marekw1986/WiFiGeiger/hardware/flyback/WiFiGeiger.brd

## EAGLE design hardware/flyback/WiFiGeiger.brd (2020-09-19)

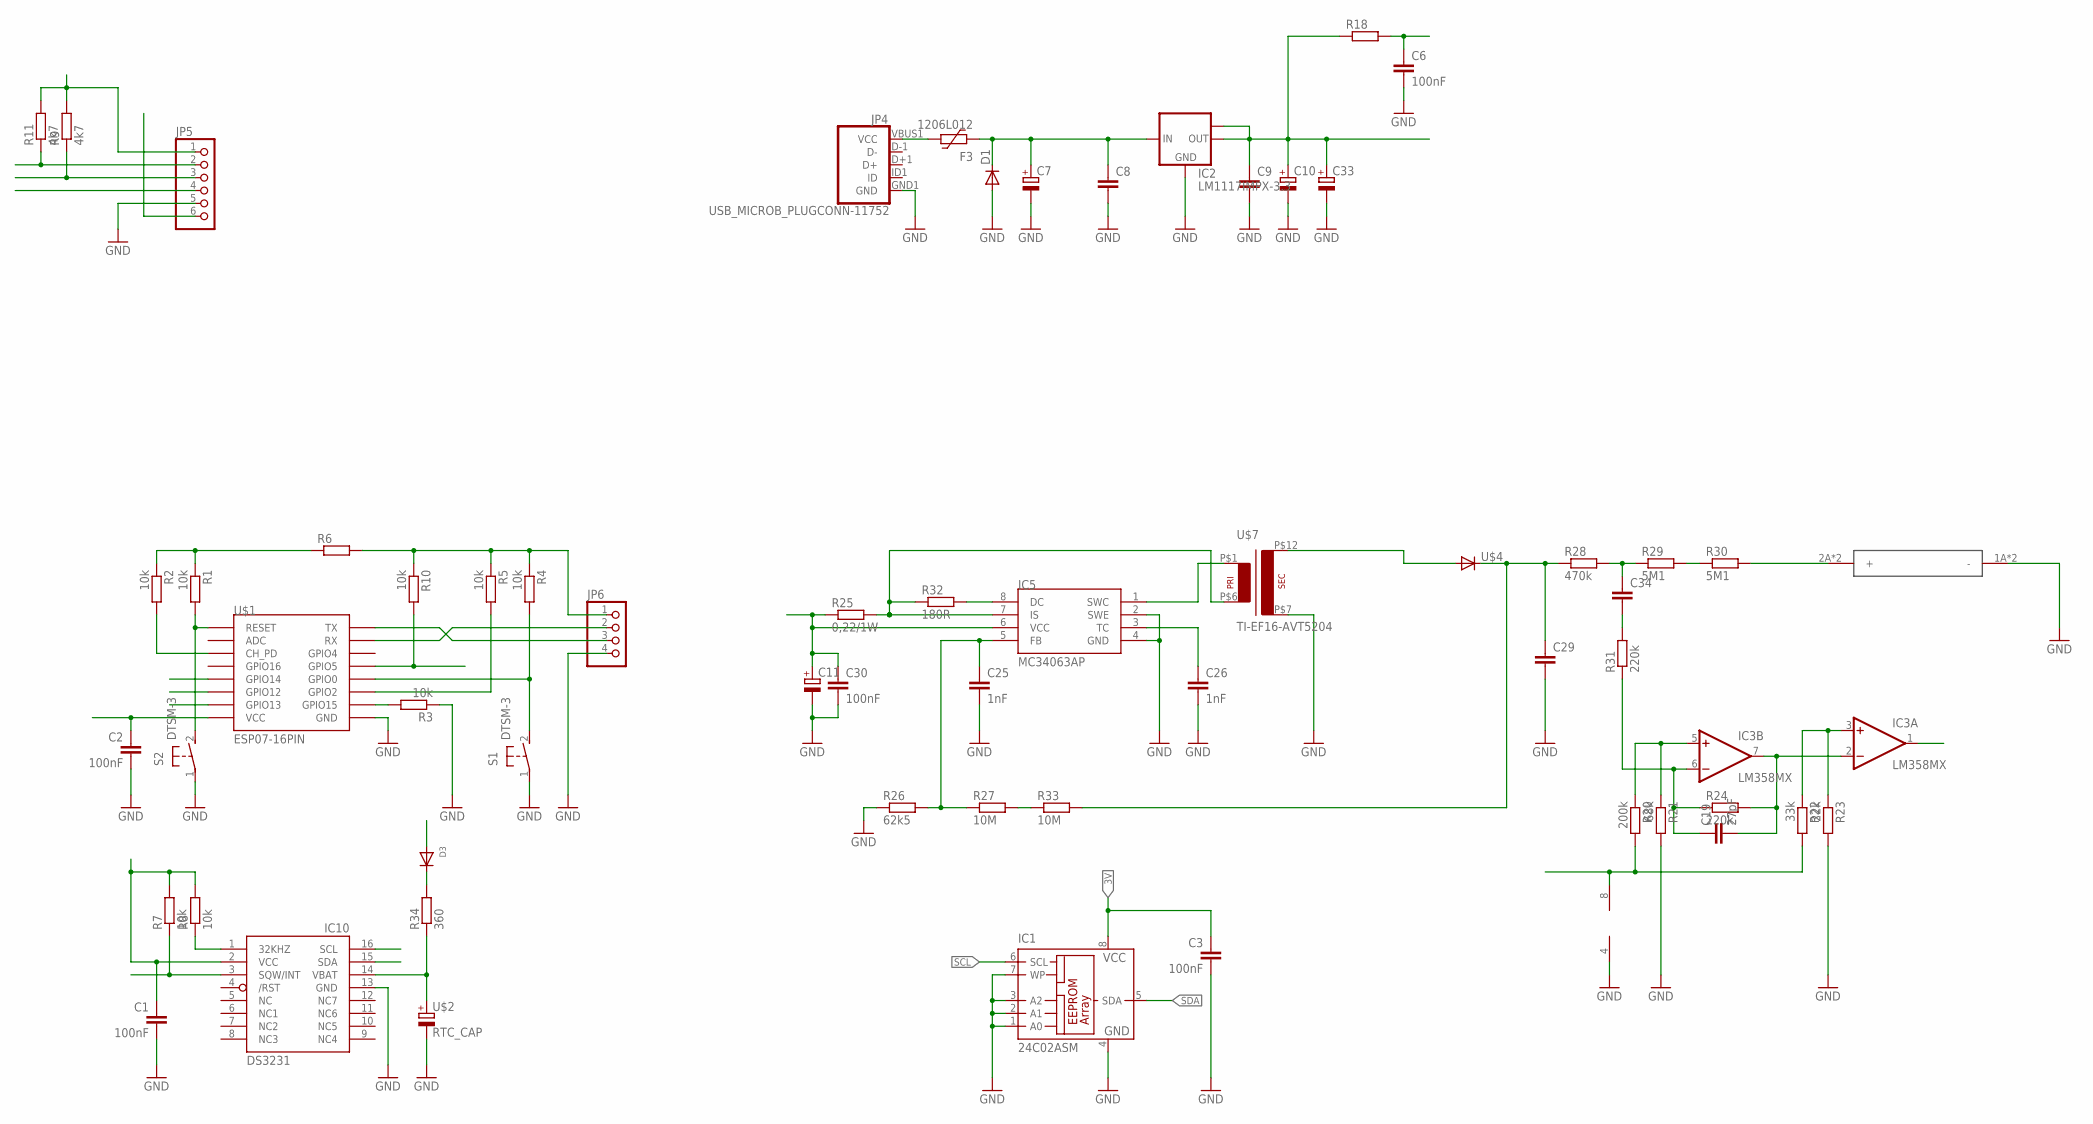
[picture p1: schematic WiFiGeiger.sch]

Parts:
C1, C2, C3, C6, C30: 100nF; C0603
C7, C10: CPOL-EUSMCC; SMC_C
C8, C9: C-EUC1206; C1206
C11: CPOL-EUSMCE; SMC_E
C19: 27pF; C0603
C25, C26: 1nF; C0603
C29: C-EU225-113X268; C225-113X268
C33: CPOL-EUSMCB; SMC_B
C34: C-EU050-024X044; C050-024X044
D1: DIODE-SMB; SMB
D3: DIODESMA; SMADIODE
F3: 1206L012; 1206L
IC1: 24C02ASM; SO-08M
IC2: LM1117IMPX-3.3; SOT223
IC3: LM358MX; SO08
IC5: MC34063AP; DIL08
IC10: DS3231/SO; SO16W
JP4: USB_MICROB_PLUGCONN-11752; USB-B-MICRO-SMD_V03
JP5: PINHD-1X6; 1X06
JP6: PINHD-1X4; 1X04
R1, R2, R3, R4, R5, R7, R8, R10: 10k; R0603
R6: R-EU_R2010; R2010
R9, R11: 4k7; R0603
R18: R-EU_R1206; R1206
R20: 200k; R0603
R21: 68k; R0603
R22: 33k; R1206
R23: 22k; R0603
R24: 220k; R0603
R25: 0,22/1W; R2010
R26: 62k5; R1206
R27, R33: 10M; R2512
R28: 470k; R2512
R29, R30: 5M1; R2512
R31: 220k; R0805
R32: 180R; R0805
R34: 360; R0603
S1, S2: DTSM-3
U$1: ESP07-16PIN
U$2: RTC_CAP
U$4: DIODE-MELF-MLL41; MELF-MLL41
U$5: STS5; GEIGERTUBE
U$7: TI-EF16-AVT5204; EF16-K-H-12P-12,5

Connections:
3V: JP6.1, R4.1, R5.1, R6.2, R10.1
A_3V: C6.1, IC3.8 (V+), R18.2, R20.2, R22.2
CPM: IC3.1 (OUT), R10.2, U$1.GPIO5
GND: C1.2, C2.2, C3.2, C6.2, C7.-, C8.2, C9.2, C10.-, C11.-, C25.2, C26.2, C29.2, C30.2, C33.-, D1.A, IC1.1 (A0), IC1.2 (A1), IC1.3 (A2), IC1.4 (GND), IC1.7 (WP), IC2.1 (GND), IC3.4 (V-), IC5.2 (SWE), IC5.4 (GND), IC10.13 (GND), JP4.GND1 (GND), JP5.5, JP6.4, R3.1, R21.2, R23.2, R26.1, S1.1, S2.1, U$1.GND, U$2.P$2 (-), U$5.1A (-), U$5.1B (-), U$7.P$7 (P7)
HV: C29.1, R28.1, R33.2, U$4.C
IO_INT: JP5.4
unnamed: R1.2, S2.2, U$1.REST (RESET)
unnamed: R2.2, U$1.CH_PD
unnamed: IC5.7 (IS), R25.2, R32.1, U$7.P$6 (P6)
unnamed: C19.1, IC3.6 (-IN), R24.1, R31.1
unnamed: R3.2, U$1.GPIO15
unnamed: R4.2, S1.2, U$1.GPIO0
unnamed: C19.2, IC3.2 (-IN), IC3.7 (OUT), R24.2
unnamed: R5.2, U$1.GPIO2
unnamed: C26.1, IC5.3 (TC)
unnamed: IC10.14 (VBAT), R34.1, U$2.P$1 (+)
unnamed: IC10.1 (32KHZ), R8.1
unnamed: F3.1, JP4.VBUS1 (VCC)
unnamed: JP6.3, U$1.TX
unnamed: D3.C, R34.2
unnamed: IC3.5 (+IN), R20.1, R21.1
unnamed: IC3.3 (+IN), R22.1, R23.1
unnamed: U$4.A, U$7.P$12 (P12)
unnamed: JP6.2, U$1.RX
unnamed: C25.1, IC5.5 (FB), R26.2, R27.1
unnamed: R30.2, U$5.2A (+), U$5.2B (+)
unnamed: R29.2, R30.1
unnamed: C34.1, R28.2, R29.1
unnamed: C34.2, R31.2
unnamed: IC5.1 (SWC), U$7.P$1 (P1)
unnamed: IC5.8 (DC), R32.2
unnamed: R27.2, R33.1
SCL: IC1.6 (SCL), IC10.16 (SCL), JP5.3, R9.1, U$1.GPIO12
SDA: IC1.5 (SDA), IC10.15 (SDA), JP5.2, R11.1, U$1.GPIO13
SQW: IC10.3 (SQW/INT), R7.1, U$1.GPIO14
VBUS: C7.+, C8.1, C11.+, C30.1, D1.C, F3.2, IC2.3 (IN), IC5.6 (VCC), JP5.6, R25.1
_3V: C1.1, C2.1, C3.1, C9.1, C10.+, C33.+, D3.A, IC1.8 (VCC), IC2.2 (OUT), IC2.TAB (OUT1), IC10.2 (VCC), JP5.1, R1.1, R2.1, R6.1, R7.2, R8.2, R9.2, R11.2, R18.1, U$1.VCC

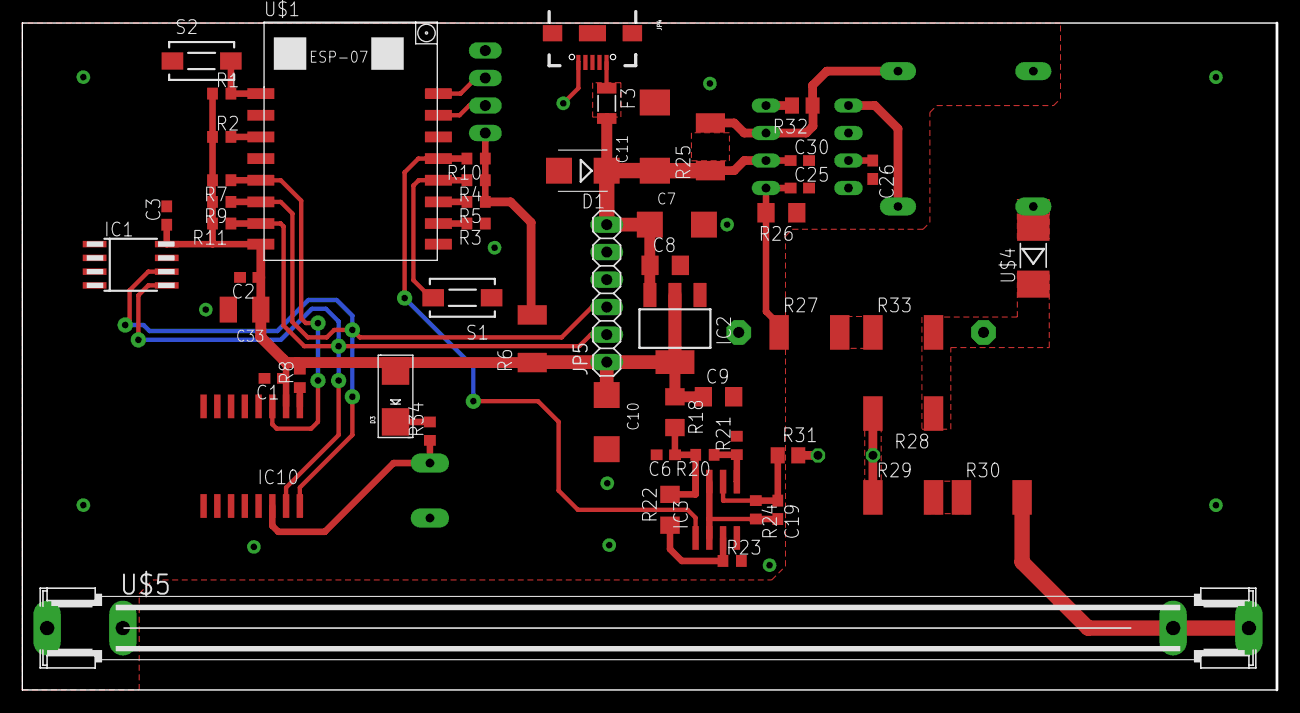
[picture p2: board WiFiGeiger.brd from above]

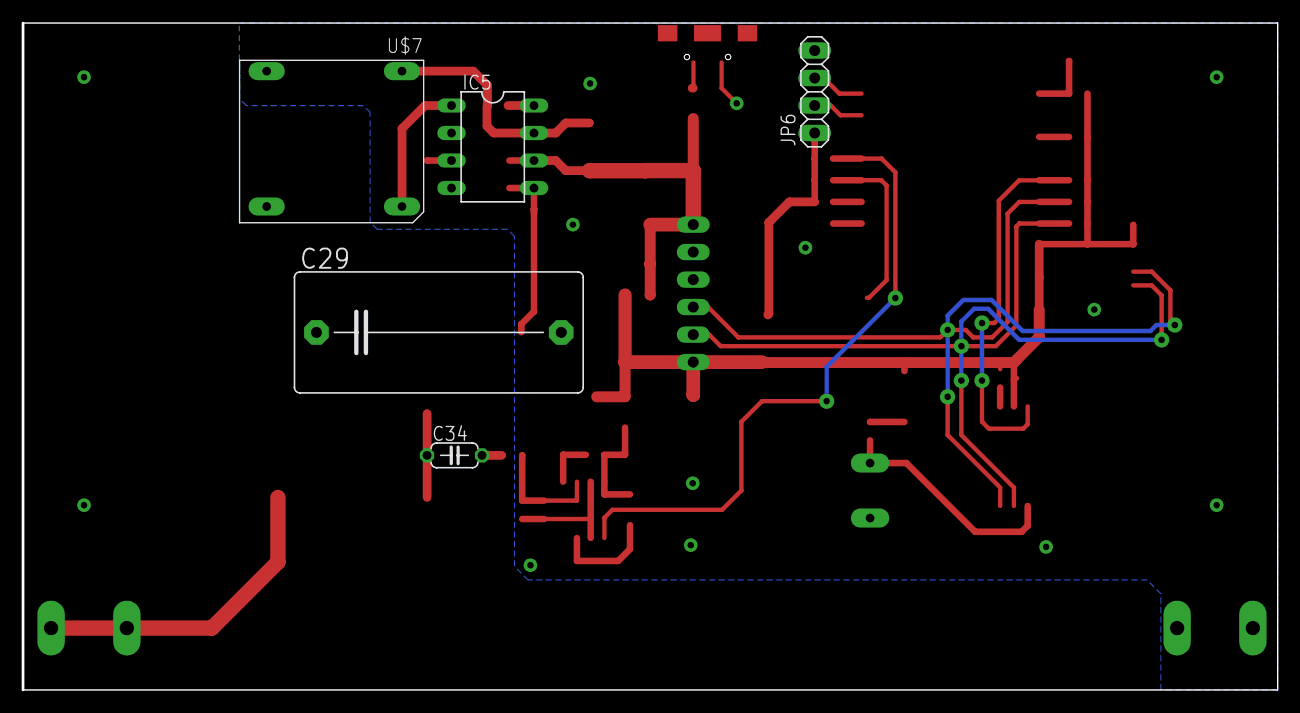
[picture p3: board WiFiGeiger.brd from below]

Board: 2 copper layers, 115.9 x 61.6 mm, 61 parts (5 on the bottom side), 36 nets.
