marekw1986/WiFiGeiger/hardware/io.brd

## EAGLE design hardware/io.brd (2020-09-19)

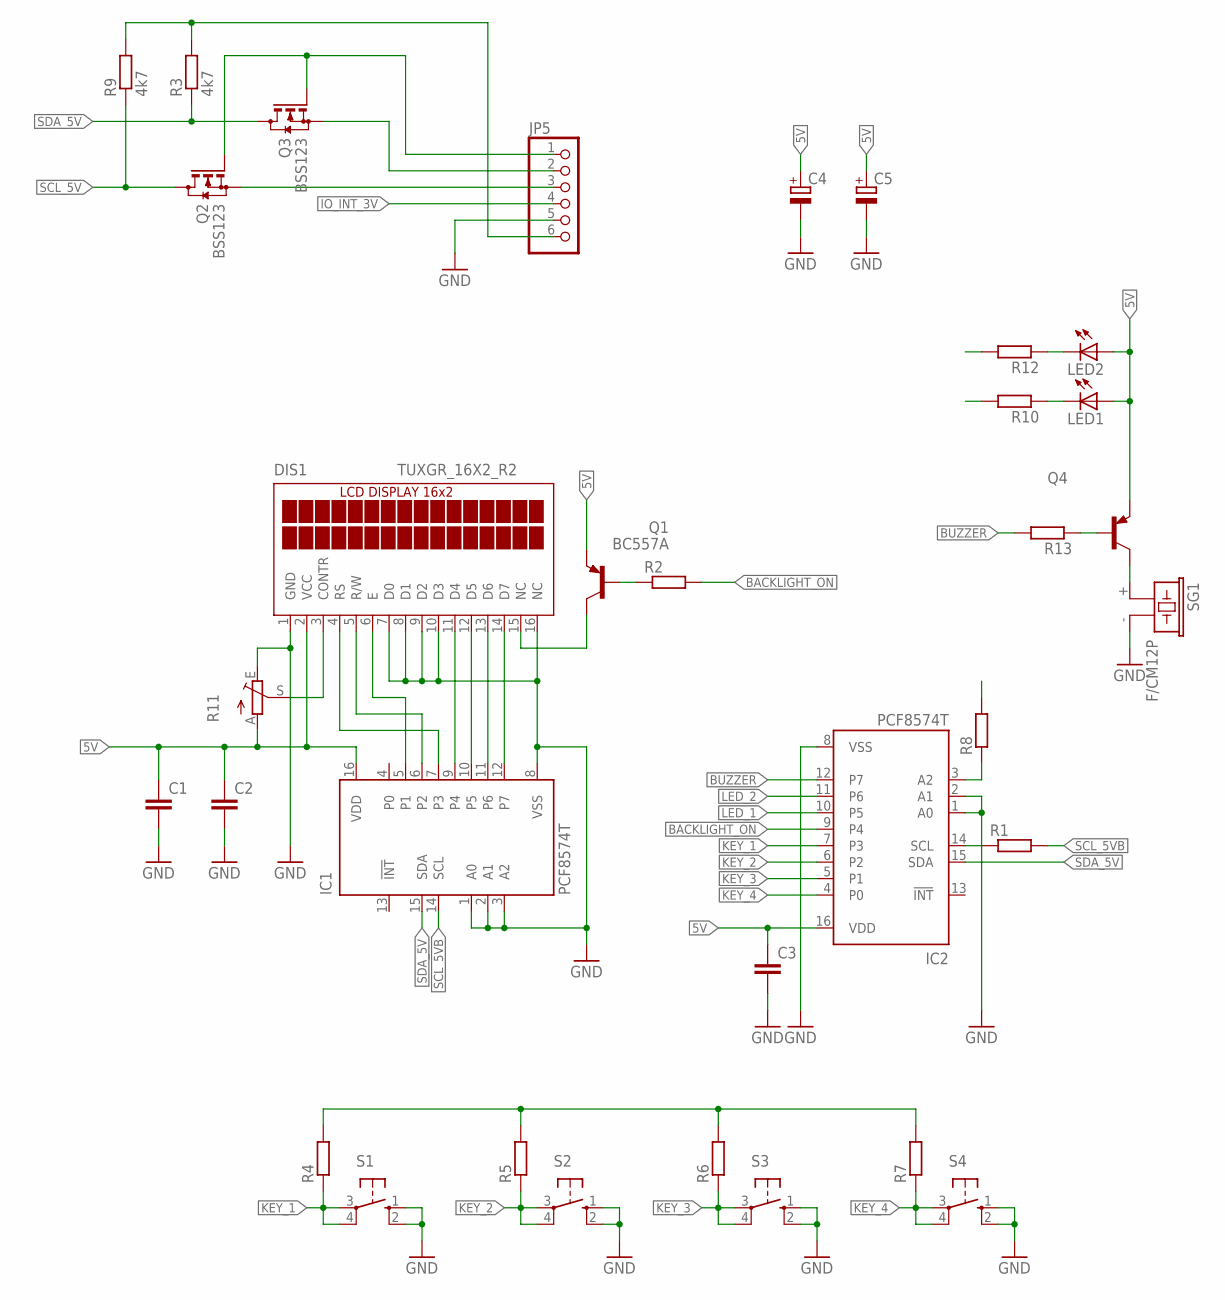
[picture p4: schematic io.sch]

Parts:
C1, C3: C-EUC1206; C1206
C2: C-EUC0603; C0603
C4, C5: CPOL-EUSMCD; SMC_D
DIS1: TUXGR_16X2_R2
IC1, IC2: PCF8574T; SO16W
JP5: PINHD-1X6; 1X06
LED1, LED2: LED5MM
Q1: BC557A; TO92-EBC
Q2, Q3: BSS123; SOT23
Q4: BC557A-PNP-TO92-EBC; TO92-EBC
R1, R8, R13: R-EU_R0603; R0603
R2, R6, R7, R10, R12: R-EU_0204/5; 0204/5
R3: 4k7; R0603
R4, R5: R-EU_0204/7; 0204/7
R9: 4k7; R1206
R11: TRIM_EU-B25U; B25U
S1, S2, S3, S4: 10-XX; B3F-10XX
SG1: F/CM12P

Connections:
5V: C1.1, C2.1, C3.1, C4.+, C5.+, DIS1.2 (VCC), IC1.16 (VDD), IC2.16 (VDD), JP5.6, LED1.A, LED2.A, Q1.E, Q4.E, R3.2, R4.2, R5.2, R6.2, R7.2, R8.2, R9.2, R11.A
BACKLIGHT_ON: IC2.9 (P4), R2.2
BUZZER: IC2.12 (P7), R13.2
GND: C1.2, C2.2, C3.2, C4.-, C5.-, DIS1.1 (GND), DIS1.7 (D0), DIS1.8 (D1), DIS1.9 (D2), DIS1.10 (D3), DIS1.16 (NC), IC1.1 (A0), IC1.2 (A1), IC1.3 (A2), IC1.8 (VSS), IC2.1 (A0), IC2.2 (A1), IC2.8 (VSS), JP5.5, R11.E, S1.1 (S), S1.2 (S1), S2.1 (S), S2.2 (S1), S3.1 (S), S3.2 (S1), S4.1 (S), S4.2 (S1), SG1.- (2)
IO_INT_3V: JP5.4
KEY_1: IC2.7 (P3), R4.1, S1.3, S1.4 (P1)
KEY_2: IC2.6 (P2), R5.1, S2.3, S2.4 (P1)
KEY_3: IC2.5 (P1), R6.1, S3.3, S3.4 (P1)
KEY_4: IC2.4 (P0), R7.1, S4.3, S4.4 (P1)
LED_1: IC2.10 (P5), R10.2
LED_2: IC2.11 (P6), R12.2
unnamed: DIS1.14 (D7), IC1.12 (P7)
unnamed: DIS1.13 (D6), IC1.11 (P6)
unnamed: DIS1.12 (D5), IC1.10 (P5)
unnamed: DIS1.11 (D4), IC1.9 (P4)
unnamed: DIS1.6 (E), IC1.5 (P1)
unnamed: DIS1.5 (R/W), IC1.6 (P2)
unnamed: DIS1.4 (RS), IC1.7 (P3)
unnamed: IC2.3 (A2), R8.1
unnamed: DIS1.15 (NC), Q1.C
unnamed: Q1.B, R2.1
unnamed: DIS1.3 (CONTR), R11.S
unnamed: LED1.K (C), R10.1
unnamed: LED2.K (C), R12.1
unnamed: Q4.C, SG1.+ (1)
unnamed: Q4.B, R13.1
SCL_3V: JP5.3, Q2.2 (S)
SCL_5V: IC2.14 (SCL), Q2.3 (D), R1.1, R9.1
SCL_5VB: IC1.14 (SCL), R1.2
SDA_3V: JP5.2, Q3.2 (S)
SDA_5V: IC1.15 (SDA), IC2.15 (SDA), Q3.3 (D), R3.1
_3V: JP5.1, Q2.1 (G), Q3.1 (G)

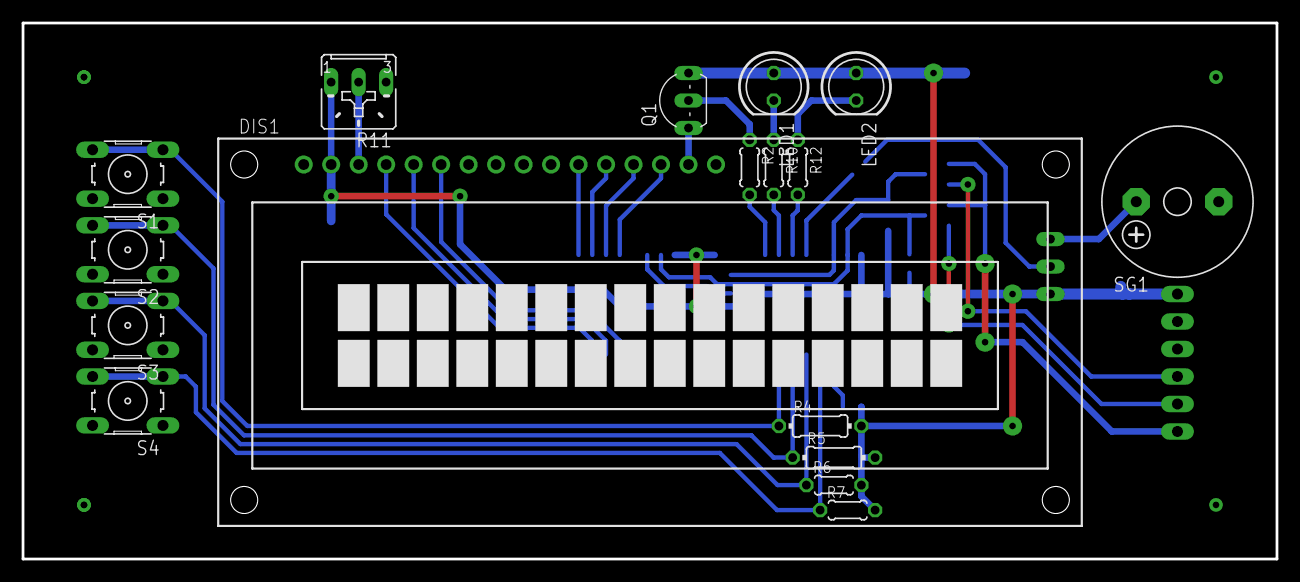
[picture p5: board io.brd from above]

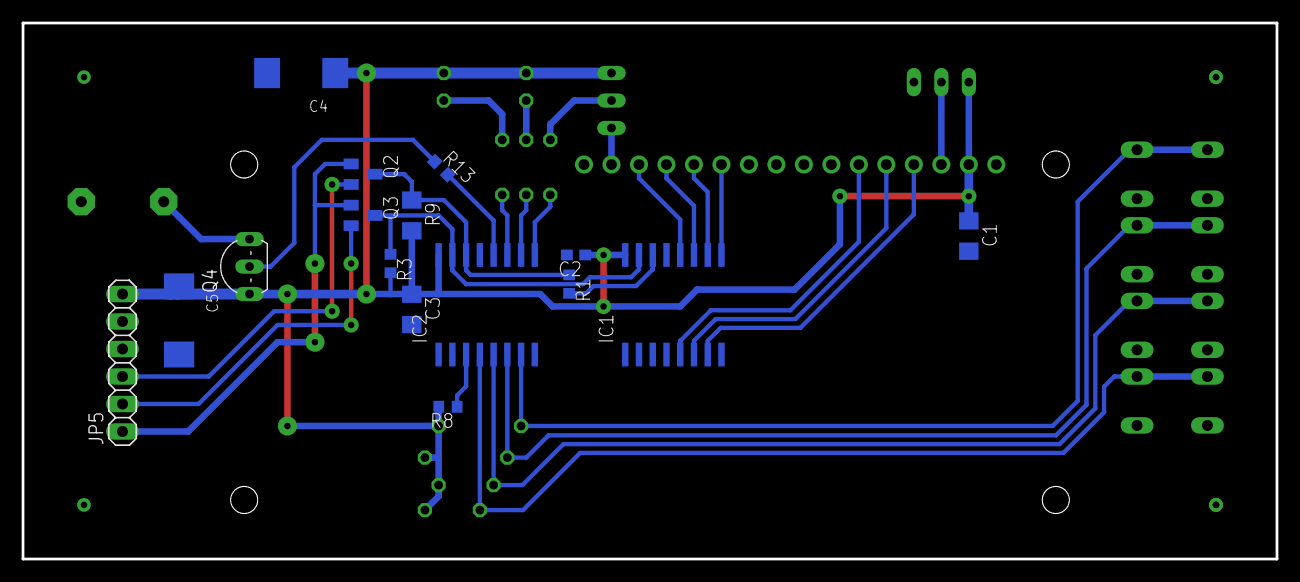
[picture p6: board io.brd from below]

Board: 2 copper layers, 115.9 x 49.5 mm, 33 parts (16 on the bottom side), 31 nets.
