marekw1986/WiFiGeiger/code/main/wifi.c

#include <string.h>
#include "freertos/FreeRTOS.h"
#include "freertos/task.h"
#include "freertos/event_groups.h"
#include "esp_system.h"
#include "esp_log.h"
#include "esp_netif.h"
#include "esp_event.h"
#include "esp_wifi.h"
#include "nvs.h"
#include "nvs_flash.h"

#include "lwip/err.h"
#include "lwip/sys.h"

#include "wifi.h"
#include "config.h"
#include "mqtt_log.h"

/* FreeRTOS event group to signal when we are connected*/
static EventGroupHandle_t s_wifi_event_group;

static const char *TAG = "WiFi driver";

static int s_retry_num = 0;
uint8_t sta_reconnect = 1;
conTryStatus_t connTryStatus=CONNTRY_IDLE;

static void event_handler(void* arg, esp_event_base_t event_base,
                                int32_t event_id, void* event_data)
{
	if (event_base == WIFI_EVENT) {
		if (event_id == WIFI_EVENT_STA_START) {
			esp_wifi_connect();
            sta_reconnect = 1;
            s_retry_num = 0;
		}
		else if (event_id == WIFI_EVENT_STA_DISCONNECTED) {
			if (sta_reconnect) {
				if (s_retry_num < EXAMPLE_ESP_MAXIMUM_RETRY)  {
					esp_wifi_connect();
					conTryStatus = CONNTRY_WORKING;
					s_retry_num++;
					ESP_LOGI(TAG, "retry to connect to the AP");
				}
				else {
					conTryStatus = CONNTRY_FAIL;
					ESP_LOGI(TAG,"connect to the AP fail");
				}
			}
		}
		else if (event_id == WIFI_EVENT_AP_STACONNECTED) {
			wifi_event_ap_staconnected_t* event = (wifi_event_ap_staconnected_t*) event_data;
			ESP_LOGI(TAG, "station "MACSTR" join, AID=%d",
					 MAC2STR(event->mac), event->aid);
		}
		else if (event_id == WIFI_EVENT_AP_STADISCONNECTED) {
			wifi_event_ap_stadisconnected_t* event = (wifi_event_ap_stadisconnected_t*) event_data;
			ESP_LOGI(TAG, "station "MACSTR" leave, AID=%d",
					 MAC2STR(event->mac), event->aid);
		}
	}
	else if (event_base == IP_EVENT) {
		if (event_id == IP_EVENT_STA_GOT_IP) {
            conTryStatus = CONNTRY_SUCCESS;
			ip_event_got_ip_t* event = (ip_event_got_ip_t*) event_data;
			ESP_LOGI(TAG, "got ip:%s",
					 ip4addr_ntoa(&event->ip_info.ip));
            
			s_retry_num = 0;
		}
	}    
}

void wifi_init(void) {
    s_wifi_event_group = xEventGroupCreate();

    tcpip_adapter_init();
    config_t config;
	config_get_current(&config);
	if (!config.use_dhcp) {
		tcpip_adapter_dhcpc_stop(TCPIP_ADAPTER_IF_STA);
		tcpip_adapter_ip_info_t ip_info;
		ip_info.ip.addr = config.ip.addr;
		ip_info.gw.addr = config.gw.addr;
		ip_info.netmask.addr = config.netmask.addr;
		tcpip_adapter_set_ip_info(TCPIP_ADAPTER_IF_STA, &ip_info);
	}    

    wifi_init_config_t cfg = WIFI_INIT_CONFIG_DEFAULT();
    ESP_ERROR_CHECK(esp_wifi_init(&cfg));
    ESP_ERROR_CHECK(esp_event_handler_register(WIFI_EVENT, ESP_EVENT_ANY_ID, &event_handler, NULL));
    ESP_ERROR_CHECK(esp_event_handler_register(IP_EVENT, IP_EVENT_STA_GOT_IP, &event_handler, NULL));
    ESP_ERROR_CHECK(esp_wifi_start());    
}

void wifi_init_sta(void) {
    s_wifi_event_group = xEventGroupCreate();

    tcpip_adapter_init();

    wifi_init_config_t cfg = WIFI_INIT_CONFIG_DEFAULT();
    ESP_ERROR_CHECK(esp_wifi_init(&cfg));

    ESP_ERROR_CHECK(esp_event_handler_register(WIFI_EVENT, ESP_EVENT_ANY_ID, &event_handler, NULL));
    ESP_ERROR_CHECK(esp_event_handler_register(IP_EVENT, IP_EVENT_STA_GOT_IP, &event_handler, NULL));

    wifi_config_t wifi_config = {
        .sta = {
            .ssid = EXAMPLE_ESP_WIFI_SSID,
            .password = EXAMPLE_ESP_WIFI_PASS
        },
    };

    /* Setting a password implies station will connect to all security modes including WEP/WPA.
        * However these modes are deprecated and not advisable to be used. Incase your Access point
        * doesn't support WPA2, these mode can be enabled by commenting below line */

    if (strlen((char *)wifi_config.sta.password)) {
        wifi_config.sta.threshold.authmode = WIFI_AUTH_WPA2_PSK;
    }

    ESP_ERROR_CHECK(esp_wifi_set_mode(WIFI_MODE_STA) );
    ESP_ERROR_CHECK(esp_wifi_set_config(ESP_IF_WIFI_STA, &wifi_config) );
    ESP_ERROR_CHECK(esp_wifi_start() );

    conTryStatus = CONNTRY_WORKING;
    ESP_LOGI(TAG, "wifi_init_sta finished.");

    /* Waiting until either the connection is established (WIFI_CONNECTED_BIT) or connection failed for the maximum
     * number of re-tries (WIFI_FAIL_BIT). The bits are set by event_handler() (see above) */
    EventBits_t bits = xEventGroupWaitBits(s_wifi_event_group,
            WIFI_CONNECTED_BIT | WIFI_FAIL_BIT,
            pdFALSE,
            pdFALSE,
            portMAX_DELAY);

    /* xEventGroupWaitBits() returns the bits before the call returned, hence we can test which event actually
     * happened. */
    if (bits & WIFI_CONNECTED_BIT) {
        ESP_LOGI(TAG, "connected to ap SSID:%s password:%s",
                 EXAMPLE_ESP_WIFI_SSID, EXAMPLE_ESP_WIFI_PASS);
    } else if (bits & WIFI_FAIL_BIT) {
        ESP_LOGI(TAG, "Failed to connect to SSID:%s, password:%s",
                 EXAMPLE_ESP_WIFI_SSID, EXAMPLE_ESP_WIFI_PASS);
    } else {
        ESP_LOGE(TAG, "UNEXPECTED EVENT");
    }

    ESP_ERROR_CHECK(esp_event_handler_unregister(IP_EVENT, IP_EVENT_STA_GOT_IP, &event_handler));
    ESP_ERROR_CHECK(esp_event_handler_unregister(WIFI_EVENT, ESP_EVENT_ANY_ID, &event_handler));
    vEventGroupDelete(s_wifi_event_group);
}

void wifi_init_apsta(void) {
    s_wifi_event_group = xEventGroupCreate();

    tcpip_adapter_init();

    wifi_init_config_t cfg = WIFI_INIT_CONFIG_DEFAULT();
    ESP_ERROR_CHECK(esp_wifi_init(&cfg));

    ESP_ERROR_CHECK(esp_event_handler_register(WIFI_EVENT, ESP_EVENT_ANY_ID, &event_handler, NULL));
    ESP_ERROR_CHECK(esp_event_handler_register(IP_EVENT, IP_EVENT_STA_GOT_IP, &event_handler, NULL));

    wifi_config_t wifi_sta_config = {
        .sta = {
            .ssid = EXAMPLE_ESP_WIFI_SSID,
            .password = EXAMPLE_ESP_WIFI_PASS
        },
    };
    
    wifi_config_t wifi_ap_config = {
        .ap = {
            .ssid = EXAMPLE_ESP_SOFTAP_WIFI_SSID,
            .ssid_len = strlen(EXAMPLE_ESP_SOFTAP_WIFI_SSID),
            .password = EXAMPLE_ESP_SOFTAP_WIFI_PASS,
            .max_connection = EXAMPLE_MAX_SOFTAP_STA_CONN,
            .authmode = WIFI_AUTH_WPA_WPA2_PSK
        },
    };    
    if (strlen(EXAMPLE_ESP_WIFI_PASS) == 0) {
        wifi_ap_config.ap.authmode = WIFI_AUTH_OPEN;
    }

    /* Setting a password implies station will connect to all security modes including WEP/WPA.
        * However these modes are deprecated and not advisable to be used. Incase your Access point
        * doesn't support WPA2, these mode can be enabled by commenting below line */

    if (strlen((char *)wifi_sta_config.sta.password)) {
        wifi_sta_config.sta.threshold.authmode = WIFI_AUTH_WPA2_PSK;
    }

    ESP_ERROR_CHECK(esp_wifi_set_mode(WIFI_MODE_APSTA) );
    ESP_ERROR_CHECK(esp_wifi_set_config(ESP_IF_WIFI_STA, &wifi_sta_config) );
    ESP_ERROR_CHECK(esp_wifi_set_config(ESP_IF_WIFI_AP, &wifi_ap_config) );
    ESP_ERROR_CHECK(esp_wifi_start() );

    conTryStatus = CONNTRY_WORKING;
    ESP_LOGI(TAG, "wifi_init_apsta finished.");

    /* Waiting until either the connection is established (WIFI_CONNECTED_BIT) or connection failed for the maximum
     * number of re-tries (WIFI_FAIL_BIT). The bits are set by event_handler() (see above) */
    EventBits_t bits = xEventGroupWaitBits(s_wifi_event_group,
            WIFI_CONNECTED_BIT | WIFI_FAIL_BIT,
            pdFALSE,
            pdFALSE,
            portMAX_DELAY);

    /* xEventGroupWaitBits() returns the bits before the call returned, hence we can test which event actually
     * happened. */
    if (bits & WIFI_CONNECTED_BIT) {
        ESP_LOGI(TAG, "connected to ap SSID:%s password:%s",
                 EXAMPLE_ESP_WIFI_SSID, EXAMPLE_ESP_WIFI_PASS);
    } else if (bits & WIFI_FAIL_BIT) {
        ESP_LOGI(TAG, "Failed to connect to SSID:%s, password:%s",
                 EXAMPLE_ESP_WIFI_SSID, EXAMPLE_ESP_WIFI_PASS);
    } else {
        ESP_LOGE(TAG, "UNEXPECTED EVENT");
    }

    ESP_ERROR_CHECK(esp_event_handler_unregister(IP_EVENT, IP_EVENT_STA_GOT_IP, &event_handler));
    ESP_ERROR_CHECK(esp_event_handler_unregister(WIFI_EVENT, ESP_EVENT_ANY_ID, &event_handler));
    vEventGroupDelete(s_wifi_event_group);
}

void wifi_init_softap(void) {
//    tcpip_adapter_init();
//    wifi_init_config_t cfg = WIFI_INIT_CONFIG_DEFAULT();
//    ESP_ERROR_CHECK(esp_wifi_init(&cfg));

//    ESP_ERROR_CHECK(esp_event_handler_register(WIFI_EVENT, ESP_EVENT_ANY_ID, &event_handler, NULL));

    wifi_config_t wifi_config = {
        .ap = {
            .ssid = EXAMPLE_ESP_SOFTAP_WIFI_SSID,
            .ssid_len = strlen(EXAMPLE_ESP_SOFTAP_WIFI_SSID),
            .password = EXAMPLE_ESP_SOFTAP_WIFI_PASS,
            .max_connection = EXAMPLE_MAX_SOFTAP_STA_CONN,
            .authmode = WIFI_AUTH_WPA_WPA2_PSK
        },
    };
    if (strlen(EXAMPLE_ESP_WIFI_PASS) == 0) {
        wifi_config.ap.authmode = WIFI_AUTH_OPEN;
    }

	sta_reconnect = 0;
	ESP_ERROR_CHECK(esp_wifi_stop());
    ESP_ERROR_CHECK(esp_wifi_set_mode(WIFI_MODE_AP));
    ESP_ERROR_CHECK(esp_wifi_set_config(ESP_IF_WIFI_AP, &wifi_config));
    ESP_ERROR_CHECK(esp_wifi_start());

    ESP_LOGI(TAG, "wifi_init_softap finished. SSID:%s password:%s",
             EXAMPLE_ESP_SOFTAP_WIFI_SSID, EXAMPLE_ESP_SOFTAP_WIFI_PASS);
}

void wifi_connect_to_ap(const char* ssid, const char* password) {
    wifi_mode_t mode;
    
	wifi_config_t wifi_sta_config = {
        .sta = {
            .ssid = EXAMPLE_ESP_WIFI_SSID,
            .password = EXAMPLE_ESP_WIFI_PASS
        },
    };
    
    if (esp_wifi_get_mode(&mode) != ESP_OK) return;
    if (mode == WIFI_MODE_AP) return;
    if (strlen(ssid) == 0) return;
    
    if ( (strlen(password) > 0) && (strlen(password) < 8) ) {
        return;
    } 

    strncpy((char*)wifi_sta_config.sta.ssid, ssid, sizeof(wifi_sta_config.sta.ssid)-1);
    strncpy((char*)wifi_sta_config.sta.password, password, sizeof(wifi_sta_config.sta.password)-1);       
    if (strlen((char *)wifi_sta_config.sta.password)) {
        wifi_sta_config.sta.threshold.authmode = WIFI_AUTH_WPA2_PSK;
    }
    else {
        wifi_sta_config.sta.threshold.authmode = WIFI_AUTH_OPEN;
    }
    
    sta_reconnect = 0;
    ESP_ERROR_CHECK(esp_wifi_stop() );
    ESP_ERROR_CHECK(esp_wifi_set_config(ESP_IF_WIFI_STA, &wifi_sta_config) );
    ESP_ERROR_CHECK(esp_wifi_start() );        
}

esp_err_t wifi_connect_sta(char * ssid, char * password)
{
	ESP_LOGI(TAG, "wifi_connect_sta");
	s_retry_num = 0;
	
	wifi_config_t wifi_config;
	bzero(&wifi_config, sizeof(wifi_config_t));
	strncpy((char *)wifi_config.sta.ssid, ssid, sizeof(wifi_config.sta.ssid)-1);
	strncpy((char *)wifi_config.sta.password, password, sizeof(wifi_config.sta.password)-1);
	wifi_config.sta.threshold.authmode = WIFI_AUTH_WPA2_PSK;
	wifi_config.sta.pmf_cfg.capable = true;
	wifi_config.sta.pmf_cfg.required = false;

	//ESP_ERROR_CHECK(esp_wifi_set_mode(WIFI_MODE_STA) );
	ESP_ERROR_CHECK(esp_wifi_set_config(ESP_IF_WIFI_STA, &wifi_config) );
	//ESP_ERROR_CHECK(esp_wifi_start() );
	ESP_LOGI(TAG, "wifi_start");

	ESP_LOGI(TAG, "wifi_connect_sta finished.");
	return ESP_OK;
}

void wifi_disconnect_sta(void)
{
	ESP_LOGI(TAG, "wifi_disconnect_sta");
	s_wifi_event_group = xEventGroupCreate();
	//s_retry_num = CONFIG_ESP_MAXIMUM_RETRY;

	// Get configuration of specified interface.
	wifi_config_t wifi_config;
	ESP_ERROR_CHECK(esp_wifi_get_config(ESP_IF_WIFI_STA, &wifi_config) );

	ESP_ERROR_CHECK(esp_event_handler_register(WIFI_EVENT, ESP_EVENT_ANY_ID, &event_handler, NULL));
	ESP_ERROR_CHECK(esp_event_handler_register(IP_EVENT, IP_EVENT_STA_GOT_IP, &event_handler, NULL));
	ESP_ERROR_CHECK(esp_wifi_disconnect());

	/* Waiting until connection failed for the maximum
	 * number of re-tries (WIFI_FAIL_BIT). The bits are set by event_handler() (see above) */
	EventBits_t bits = xEventGroupWaitBits(s_wifi_event_group,
			WIFI_FAIL_BIT,
			pdFALSE,
			pdFALSE,
			portMAX_DELAY);

	/* xEventGroupWaitBits() returns the bits before the call returned, hence we can test which event actually
	 * happened. */
	if (bits & WIFI_FAIL_BIT) {
		ESP_LOGI(TAG, "disconnected to ap SSID:%s password:%s", (char *)wifi_config.sta.ssid, (char *)wifi_config.sta.password);
	} else {
		ESP_LOGE(TAG, "UNEXPECTED EVENT");
	}

	/* The event will not be processed after unregister */
	ESP_ERROR_CHECK(esp_event_handler_unregister(IP_EVENT, IP_EVENT_STA_GOT_IP, &event_handler));
	ESP_ERROR_CHECK(esp_event_handler_unregister(WIFI_EVENT, ESP_EVENT_ANY_ID, &event_handler));
	vEventGroupDelete(s_wifi_event_group);

	//esp_err_t err = esp_wifi_stop();
	//if (err == ESP_ERR_WIFI_NOT_INIT) {
	//	return;
	//}
	//ESP_ERROR_CHECK(err);

	ESP_LOGI(TAG, "wifi_disconnect_sta finished.");
}
