marekw1986/WiFiGeiger/code/main/i2c_master.h

#ifndef _I2C_MASTER_H_
#define _I2C_MASTER_H_

#include "driver/i2c.h"

#define I2C_MASTER_SCL_IO           12                /*!< gpio number for I2C master clock */
#define I2C_MASTER_SDA_IO           13               /*!< gpio number for I2C master data  */
#define I2C_MASTER_NUM              I2C_NUM_0        /*!< I2C port number for master dev */

esp_err_t i2c_master_init(void);
esp_err_t i2c_master_write_buf(i2c_port_t i2c_num, uint8_t i2c_address, uint8_t reg_address, uint8_t *data, size_t data_len);
esp_err_t i2c_master_read_buf(i2c_port_t i2c_num, uint8_t i2c_address, uint8_t reg_address, uint8_t *data, size_t data_len);

void i2c_task_example(void *arg);

#endif //_I2C_MASTER_H_
