marekw1986/WiFiGeiger/code/main/i2c_master.c

#include "i2c_master.h"

#define WRITE_BIT                           I2C_MASTER_WRITE /*!< I2C master write */
#define READ_BIT                            I2C_MASTER_READ  /*!< I2C master read */
#define ACK_CHECK_EN                        0x1              /*!< I2C master will check ack from slave*/
#define ACK_CHECK_DIS                       0x0              /*!< I2C master will not check ack from slave */
#define ACK_VAL                             0x0              /*!< I2C ack value */
#define NACK_VAL                            0x1              /*!< I2C nack value */
#define LAST_NACK_VAL                       0x2              /*!< I2C last_nack value */


esp_err_t i2c_master_init(void) {
    int i2c_master_port = I2C_MASTER_NUM;
    i2c_config_t conf;
    conf.mode = I2C_MODE_MASTER;
    conf.sda_io_num = I2C_MASTER_SDA_IO;
    conf.sda_pullup_en = 1;
    conf.scl_io_num = I2C_MASTER_SCL_IO;
    conf.scl_pullup_en = 1;
    conf.clk_stretch_tick = 300; // 300 ticks, Clock stretch is about 210us, you can make changes according to the actual situation.
    ESP_ERROR_CHECK(i2c_driver_install(i2c_master_port, conf.mode));
    ESP_ERROR_CHECK(i2c_param_config(i2c_master_port, &conf));
    return ESP_OK;
}


esp_err_t i2c_master_write_buf(i2c_port_t i2c_num, uint8_t i2c_address, uint8_t reg_address, uint8_t *data, size_t data_len) {
    int ret;
    i2c_cmd_handle_t cmd = i2c_cmd_link_create();
    i2c_master_start(cmd);
    i2c_master_write_byte(cmd, i2c_address << 1 | WRITE_BIT, ACK_CHECK_EN);
    i2c_master_write_byte(cmd, reg_address, ACK_CHECK_EN);
    i2c_master_write(cmd, data, data_len, ACK_CHECK_EN);
    i2c_master_stop(cmd);
    ret = i2c_master_cmd_begin(i2c_num, cmd, 1000 / portTICK_RATE_MS);
    i2c_cmd_link_delete(cmd);

    return ret;
}


esp_err_t i2c_master_read_buf(i2c_port_t i2c_num, uint8_t i2c_address, uint8_t reg_address, uint8_t *data, size_t data_len) {
    int ret;
    i2c_cmd_handle_t cmd = i2c_cmd_link_create();
    i2c_master_start(cmd);
    i2c_master_write_byte(cmd, i2c_address << 1 | WRITE_BIT, ACK_CHECK_EN);
    i2c_master_write_byte(cmd, reg_address, ACK_CHECK_EN);
    i2c_master_stop(cmd);
    ret = i2c_master_cmd_begin(i2c_num, cmd, 1000 / portTICK_RATE_MS);
    i2c_cmd_link_delete(cmd);

    if (ret != ESP_OK) {
        return ret;
    }

    cmd = i2c_cmd_link_create();
    i2c_master_start(cmd);
    i2c_master_write_byte(cmd, i2c_address << 1 | READ_BIT, ACK_CHECK_EN);
    i2c_master_read(cmd, data, data_len, LAST_NACK_VAL);
    i2c_master_stop(cmd);
    ret = i2c_master_cmd_begin(i2c_num, cmd, 1000 / portTICK_RATE_MS);
    i2c_cmd_link_delete(cmd);

    return ret;
}
