marekw1986/WiFiGeiger/(commit log)

2022-05-31 some possible memory leaks avoided
    [common.c, http_server.c, mqtt_log.c]
2022-06-13 i2c rtc
2022-12-06 Boost version of hardware added
    [WiFiGeiger.brd, WiFiGeiger.sch]
